MaheshGit31/EInkBadge/bom-submit.csv

Part | Name | Item | Purpose | What it's for | Description | Use | Reason | Notes | Qty | Quantity | Unit | Unit $ | Unit price | Unit Price (USD) | Unit Cost | Unit_USD | Price | Cost | Total | Vendor | Supplier | Link | URL | Product link
ESP32-S3-WROOM-1-N8 module (U1) | ESP32-S3-WROOM-1-N8 module (U1) | ESP32-S3-WROOM-1-N8 module (U1) | main MCU with Wi-Fi and Bluetooth | main MCU with Wi-Fi and Bluetooth | main MCU with Wi-Fi and Bluetooth | main MCU with Wi-Fi and Bluetooth | main MCU with Wi-Fi and Bluetooth | main MCU with Wi-Fi and Bluetooth | 1 | 1 | 4.91 | 4.91 | 4.91 | 4.91 | 4.91 | 4.91 | 4.91 | 4.91 | 4.91 | LCSC | LCSC | https://www.lcsc.com/product-detail/C2913198.html | https://www.lcsc.com/product-detail/C2913198.html | https://www.lcsc.com/product-detail/C2913198.html
MCP73831T-2ACI/OT LiPo charger (U2) | MCP73831T-2ACI/OT LiPo charger (U2) | MCP73831T-2ACI/OT LiPo charger (U2) | charges the battery from USB-C | charges the battery from USB-C | charges the battery from USB-C | charges the battery from USB-C | charges the battery from USB-C | charges the battery from USB-C | 1 | 1 | 0.71 | 0.71 | 0.71 | 0.71 | 0.71 | 0.71 | 0.71 | 0.71 | 0.71 | LCSC | LCSC | https://www.lcsc.com/product-detail/C424093.html | https://www.lcsc.com/product-detail/C424093.html | https://www.lcsc.com/product-detail/C424093.html
AP2112K-3.3TRG1 3.3V regulator (U3) | AP2112K-3.3TRG1 3.3V regulator (U3) | AP2112K-3.3TRG1 3.3V regulator (U3) | 3.3V supply for the ESP32 and display | 3.3V supply for the ESP32 and display | 3.3V supply for the ESP32 and display | 3.3V supply for the ESP32 and display | 3.3V supply for the ESP32 and display | 3.3V supply for the ESP32 and display | 1 | 1 | 0.18 | 0.18 | 0.18 | 0.18 | 0.18 | 0.18 | 0.18 | 0.18 | 0.18 | LCSC | LCSC | https://www.lcsc.com/product-detail/C51118.html | https://www.lcsc.com/product-detail/C51118.html | https://www.lcsc.com/product-detail/C51118.html
AO3401A P-FET (Q1) | AO3401A P-FET (Q1) | AO3401A P-FET (Q1) | power-path switch between USB and battery | power-path switch between USB and battery | power-path switch between USB and battery | power-path switch between USB and battery | power-path switch between USB and battery | power-path switch between USB and battery | 1 | 1 | 0.10 | 0.10 | 0.10 | 0.10 | 0.10 | 0.10 | 0.10 | 0.10 | 0.10 | LCSC | LCSC | https://www.lcsc.com/product-detail/C15127.html | https://www.lcsc.com/product-detail/C15127.html | https://www.lcsc.com/product-detail/C15127.html
SS14 Schottky diode (D1) | SS14 Schottky diode (D1) | SS14 Schottky diode (D1) | power-path diode | power-path diode | power-path diode | power-path diode | power-path diode | power-path diode | 1 | 1 | 0.02 | 0.02 | 0.02 | 0.02 | 0.02 | 0.02 | 0.02 | 0.02 | 0.02 | LCSC | LCSC | https://www.lcsc.com/product-detail/C2480.html | https://www.lcsc.com/product-detail/C2480.html | https://www.lcsc.com/product-detail/C2480.html
USB4105-GF-A-060 USB-C receptacle (J1) | USB4105-GF-A-060 USB-C receptacle (J1) | USB4105-GF-A-060 USB-C receptacle (J1) | charging and programming port | charging and programming port | charging and programming port | charging and programming port | charging and programming port | charging and programming port | 1 | 1 | 0.93 | 0.93 | 0.93 | 0.93 | 0.93 | 0.93 | 0.93 | 0.93 | 0.93 | Mouser | Mouser | https://www.mouser.com/c/?q=USB4105-GF-A-060 | https://www.mouser.com/c/?q=USB4105-GF-A-060 | https://www.mouser.com/c/?q=USB4105-GF-A-060
JST B2B-PH-K-S battery connector (J3) | JST B2B-PH-K-S battery connector (J3) | JST B2B-PH-K-S battery connector (J3) | LiPo battery connector | LiPo battery connector | LiPo battery connector | LiPo battery connector | LiPo battery connector | LiPo battery connector | 1 | 1 | 0.04 | 0.04 | 0.04 | 0.04 | 0.04 | 0.04 | 0.04 | 0.04 | 0.04 | LCSC | LCSC | https://www.lcsc.com/product-detail/C131337.html | https://www.lcsc.com/product-detail/C131337.html | https://www.lcsc.com/product-detail/C131337.html
Omron B3FS-1000P tact switch (SW1-SW3) | Omron B3FS-1000P tact switch (SW1-SW3) | Omron B3FS-1000P tact switch (SW1-SW3) | wake, boot, and reset buttons | wake, boot, and reset buttons | wake, boot, and reset buttons | wake, boot, and reset buttons | wake, boot, and reset buttons | wake, boot, and reset buttons | 3 | 3 | 0.22 | 0.22 | 0.22 | 0.22 | 0.22 | 0.22 | 0.22 | 0.22 | 0.66 | LCSC | LCSC | https://www.lcsc.com/product-detail/C271750.html | https://www.lcsc.com/product-detail/C271750.html | https://www.lcsc.com/product-detail/C271750.html
2.54mm male pin header 1x40, cut to 8 pins (J2) | 2.54mm male pin header 1x40, cut to 8 pins (J2) | 2.54mm male pin header 1x40, cut to 8 pins (J2) | display cable header | display cable header | display cable header | display cable header | display cable header | display cable header | 1 | 1 | 0.16 | 0.16 | 0.16 | 0.16 | 0.16 | 0.16 | 0.16 | 0.16 | 0.16 | LCSC | LCSC | https://www.lcsc.com/product-detail/C2337.html | https://www.lcsc.com/product-detail/C2337.html | https://www.lcsc.com/product-detail/C2337.html
Passives: 11 resistors, 11 capacitors, 2 LEDs | Passives: 11 resistors, 11 capacitors, 2 LEDs | Passives: 11 resistors, 11 capacitors, 2 LEDs | pull-ups, dividers, decoupling, status LEDs | pull-ups, dividers, decoupling, status LEDs | pull-ups, dividers, decoupling, status LEDs | pull-ups, dividers, decoupling, status LEDs | pull-ups, dividers, decoupling, status LEDs | pull-ups, dividers, decoupling, status LEDs | 1 | 1 | 0.18 | 0.18 | 0.18 | 0.18 | 0.18 | 0.18 | 0.18 | 0.18 | 0.18 | LCSC | LCSC | https://www.lcsc.com/product-detail/C23186.html | https://www.lcsc.com/product-detail/C23186.html | https://www.lcsc.com/product-detail/C23186.html
Waveshare 2.13in e-Paper HAT with 8-pin cable | Waveshare 2.13in e-Paper HAT with 8-pin cable | Waveshare 2.13in e-Paper HAT with 8-pin cable | 250x122 e-paper display | 250x122 e-paper display | 250x122 e-paper display | 250x122 e-paper display | 250x122 e-paper display | 250x122 e-paper display | 1 | 1 | 14.99 | 14.99 | 14.99 | 14.99 | 14.99 | 14.99 | 14.99 | 14.99 | 14.99 | Waveshare | Waveshare | https://www.waveshare.com/2.13inch-e-paper-hat.htm | https://www.waveshare.com/2.13inch-e-paper-hat.htm | https://www.waveshare.com/2.13inch-e-paper-hat.htm
3.7V 500mAh LiPo with JST-PH plug (Adafruit 1578) | 3.7V 500mAh LiPo with JST-PH plug (Adafruit 1578) | 3.7V 500mAh LiPo with JST-PH plug (Adafruit 1578) | battery | battery | battery | battery | battery | battery | 1 | 1 | 10.45 | 10.45 | 10.45 | 10.45 | 10.45 | 10.45 | 10.45 | 10.45 | 10.45 | Jameco | Jameco | https://www.jameco.com/z/1578-Adafruit-Industries-Lithium-Ion-Polymer-Battery-3-7V-500mAh_2505911.html | https://www.jameco.com/z/1578-Adafruit-Industries-Lithium-Ion-Polymer-Battery-3-7V-500mAh_2505911.html | https://www.jameco.com/z/1578-Adafruit-Industries-Lithium-Ion-Polymer-Battery-3-7V-500mAh_2505911.html
PCB: 5x 2-layer 85x55mm | PCB: 5x 2-layer 85x55mm | PCB: 5x 2-layer 85x55mm | the badge board | the badge board | the badge board | the badge board | the badge board | the badge board | 1 | 1 | 2.00 | 2.00 | 2.00 | 2.00 | 2.00 | 2.00 | 2.00 | 2.00 | 2.00 | JLCPCB | JLCPCB | https://jlcpcb.com/ | https://jlcpcb.com/ | https://jlcpcb.com/
M2 self-tapping screws x4 (estimate) | M2 self-tapping screws x4 (estimate) | M2 self-tapping screws x4 (estimate) | close the case | close the case | close the case | close the case | close the case | close the case | 1 | 1 | 0.80 | 0.80 | 0.80 | 0.80 | 0.80 | 0.80 | 0.80 | 0.80 | 0.80 | Amazon | Amazon | https://www.amazon.com/s?k=M2+self+tapping+screws | https://www.amazon.com/s?k=M2+self+tapping+screws | https://www.amazon.com/s?k=M2+self+tapping+screws
PLA filament, about 25g (estimate) | PLA filament, about 25g (estimate) | PLA filament, about 25g (estimate) | print the case | print the case | print the case | print the case | print the case | print the case | 1 | 1 | 0.50 | 0.50 | 0.50 | 0.50 | 0.50 | 0.50 | 0.50 | 0.50 | 0.50 | Amazon | Amazon | https://www.amazon.com/s?k=PLA+filament+1.75mm | https://www.amazon.com/s?k=PLA+filament+1.75mm | https://www.amazon.com/s?k=PLA+filament+1.75mm
