MaheshGit31/EInkBadge/eink-badge-case-assembly.step

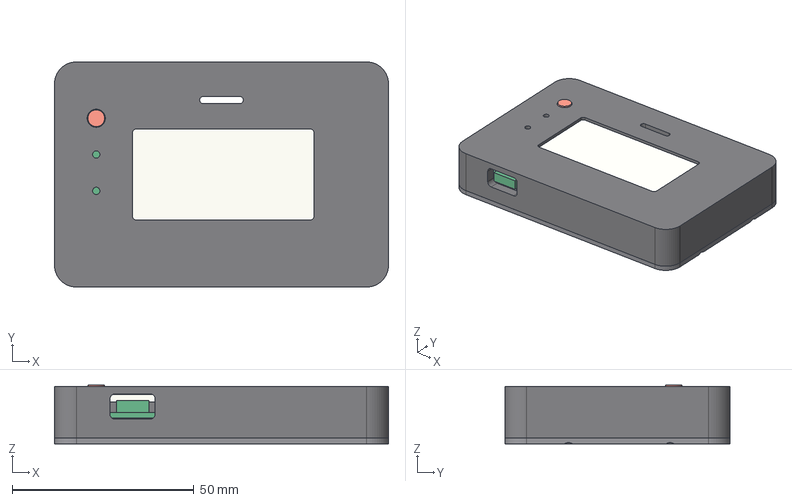
[picture p1: CAD file, 2026-11-01]
eink-badge-case-assembly.step
92.0 x 62.0 x 16.2 mm
front-shell
back-plate
wake-button-cap
ref-pcb
ref-display
