MaheshGit31/EInkBadge/back-plate.step

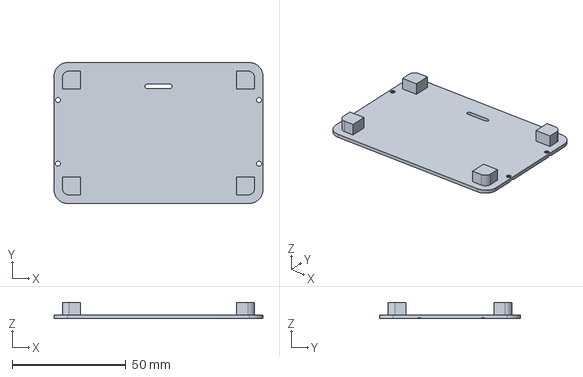
[picture p2: CAD file, 2026-11-01]
back-plate.step
92.0 x 62.0 x 7.10 mm
