MaheshGit31/EInkBadge/front-shell.step

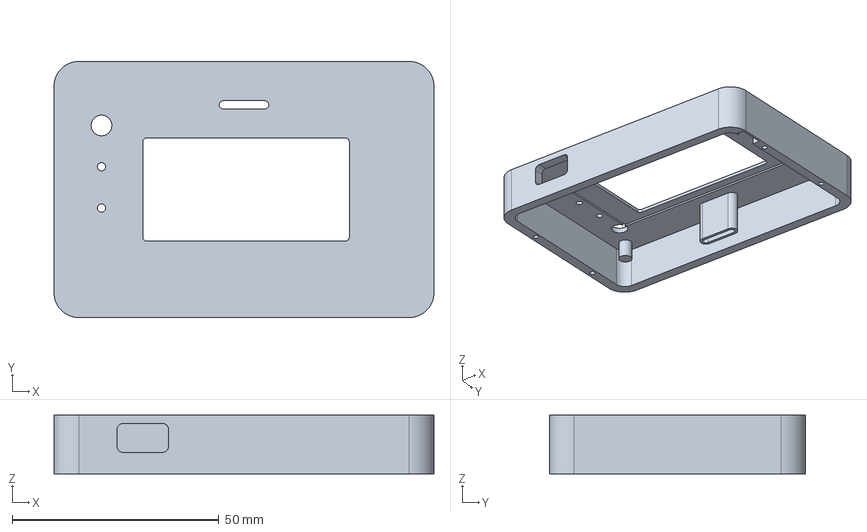
[picture p3: CAD file, 2026-11-01]
front-shell.step
92.0 x 62.0 x 14.2 mm
