MaheshGit31/EInkBadge/eink-badge.kicad_sch

## KiCad design eink-badge.kicad_sch (2026-11-01)

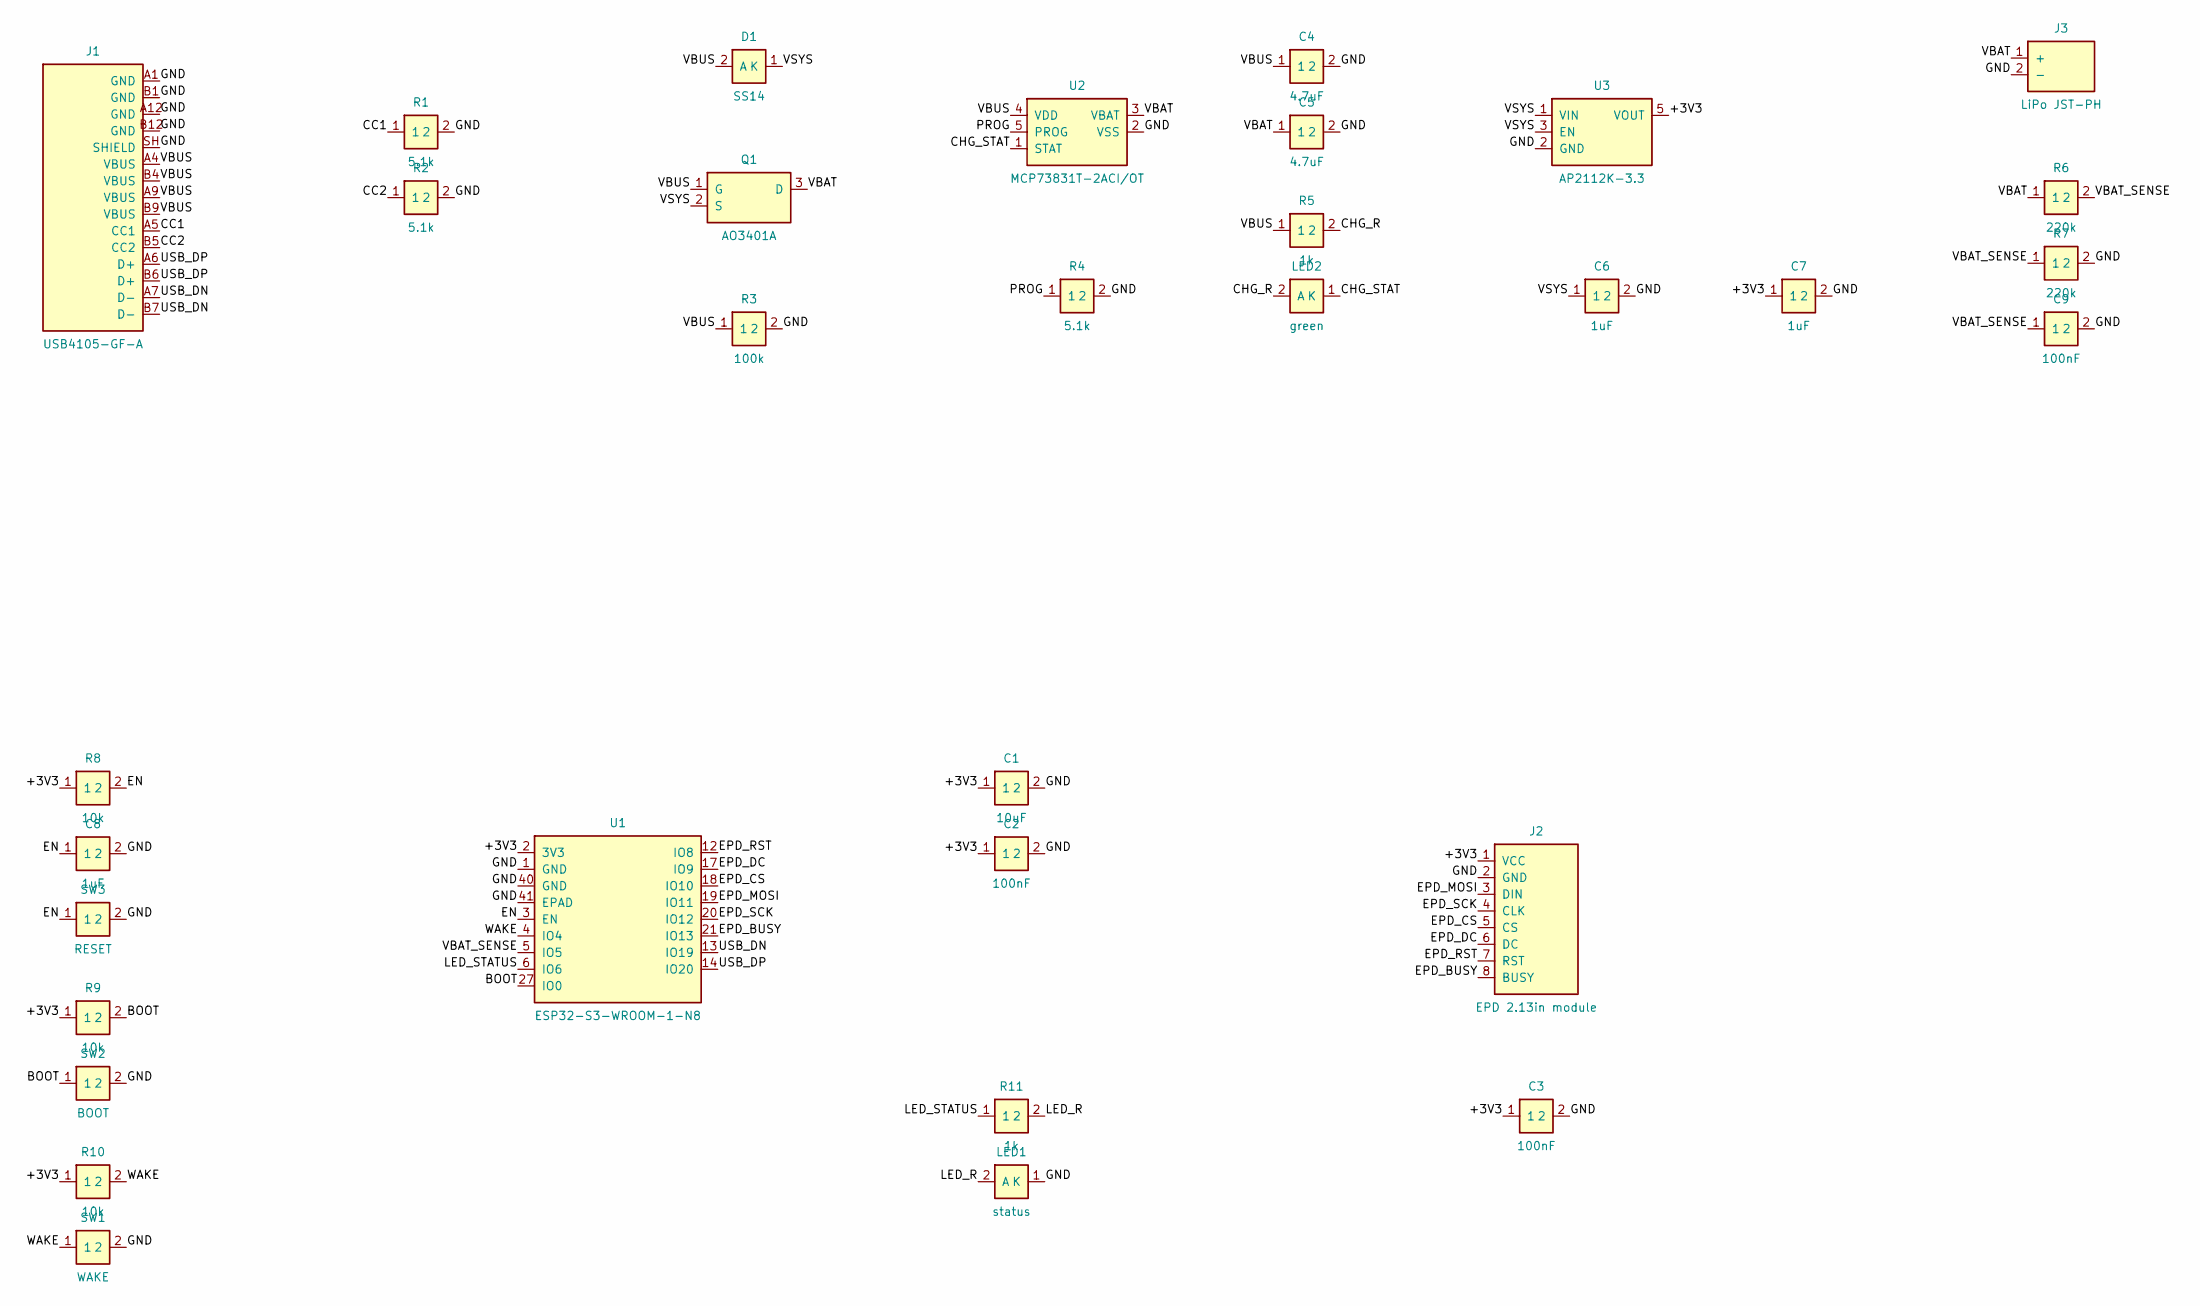
[picture p4: schematic eink-badge.kicad_sch]

Parts:
C1: 10uF; C_0805_2012Metric
C2, C3, C9: 100nF; C_0603_1608Metric
C4, C5: 4.7uF; C_0603_1608Metric
C6, C7, C8: 1uF; C_0603_1608Metric
D1: SS14; D_SMA
J1: USB4105-GF-A; USB_C_Receptacle_GCT_USB4105-xx-A_16P_TopMnt_Horizontal
J2: EPD 2.13in module; PinHeader_1x08_P2.54mm_Vertical
J3: LiPo JST-PH; JST_PH_B2B-PH-K_1x02_P2.00mm_Vertical
LED1: status; LED_0603_1608Metric
LED2: green; LED_0603_1608Metric
Q1: AO3401A; SOT-23
R1, R2, R4: 5.1k; R_0603_1608Metric
R3: 100k; R_0603_1608Metric
R5, R11: 1k; R_0603_1608Metric
R6, R7: 220k; R_0603_1608Metric
R8, R9, R10: 10k; R_0603_1608Metric
SW1: WAKE; SW_SPST_B3S-1000
SW2: BOOT; SW_SPST_B3S-1000
SW3: RESET; SW_SPST_B3S-1000
U1: ESP32-S3-WROOM-1-N8; ESP32-S3-WROOM-1
U2: MCP73831T-2ACI/OT; SOT-23-5
U3: AP2112K-3.3; SOT-23-5

Connections:
+3V3: C1.1, C2.1, C3.1, C7.1, J2.1 (VCC), R8.1, R9.1, R10.1, U1.2 (3V3), U3.5 (VOUT)
BOOT: R9.2, SW2.1, U1.27 (IO0)
CC1: J1.A5 (CC1), R1.1
CC2: J1.B5 (CC2), R2.1
CHG_R: LED2.2 (A), R5.2
CHG_STAT: LED2.1 (K), U2.1 (STAT)
EN: C8.1, R8.2, SW3.1, U1.3 (EN)
EPD_BUSY: J2.8 (BUSY), U1.21 (IO13)
EPD_CS: J2.5 (CS), U1.18 (IO10)
EPD_DC: J2.6 (DC), U1.17 (IO9)
EPD_MOSI: J2.3 (DIN), U1.19 (IO11)
EPD_RST: J2.7 (RST), U1.12 (IO8)
EPD_SCK: J2.4 (CLK), U1.20 (IO12)
GND: C1.2, C2.2, C3.2, C4.2, C5.2, C6.2, C7.2, C8.2, C9.2, J1.A1 (GND), J1.A12 (GND), J1.B1 (GND), J1.B12 (GND), J1.SH (SHIELD), J2.2 (GND), J3.2 (-), LED1.1 (K), R1.2, R2.2, R3.2, R4.2, R7.2, SW1.2, SW2.2, SW3.2, U1.1 (GND), U1.40 (GND), U1.41 (EPAD), U2.2 (VSS), U3.2 (GND)
LED_R: LED1.2 (A), R11.2
LED_STATUS: R11.1, U1.6 (IO6)
PROG: R4.1, U2.5 (PROG)
USB_DN: J1.A7 (D-), J1.B7 (D-), U1.13 (IO19)
USB_DP: J1.A6 (D+), J1.B6 (D+), U1.14 (IO20)
VBAT: C5.1, J3.1 (+), Q1.3 (D), R6.1, U2.3 (VBAT)
VBAT_SENSE: C9.1, R6.2, R7.1, U1.5 (IO5)
VBUS: C4.1, D1.2 (A), J1.A4 (VBUS), J1.A9 (VBUS), J1.B4 (VBUS), J1.B9 (VBUS), Q1.1 (G), R3.1, R5.1, U2.4 (VDD)
VSYS: C6.1, D1.1 (K), Q1.2 (S), U3.1 (VIN), U3.3 (EN)
WAKE: R10.2, SW1.1, U1.4 (IO4)
